mengwei666/microduck_scs225/readme.md

***20261104***
> 训练策略

***20261102***
>泰山派连接命令 ssh root@192.168.1.7 "uname -a"

***20261102***
> 整理文件

***20261101***
> 添加cda模型
> 添加腿部 SCS225 调试脚本与 RK3566 说明（docs/rk3566-legs-bringup.md）

***20261021***
> 添加cda模型
