mengwei666/microduck_scs225/microduck_cad/04、microduck_v2/microduck.SLDASM

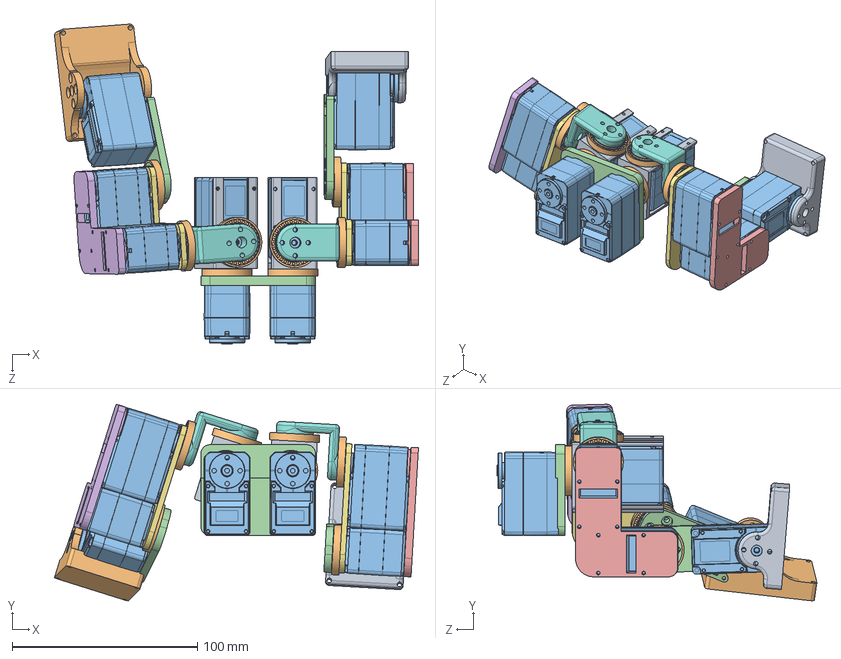
[picture p1: CAD file, 2026-11-01]
microduck_cad/04、microduck_v2/microduck.SLDASM
196.7 x 106.2 x 172.8 mm
01、主体结构
SCS225舵机 x 10
02、轴承_20_27_4X8 x 8
03、胯部X2 x 2
04、胯筋X2 x 2
05、大腿上盖X2 x 2
06、右大腿下盖
07、左大腿下盖
08、小腿X2 x 2
09、轴承_4_6_10X2 x 2
10、右脚踝
11、左脚踝
