mengwei666/microduck_scs225/microduck_cad/04、microduck_v2/SCS225舵机.SLDPRT

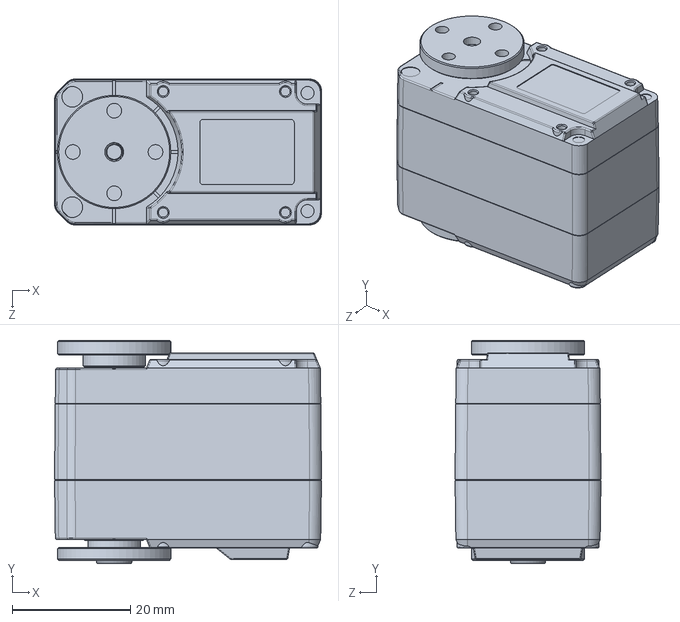
[picture p2: CAD file, 2026-11-01]
microduck_cad/04、microduck_v2/SCS225舵机.SLDPRT
45.2 x 37.8 x 24.7 mm
