mengwei666/microduck_scs225/microduck_cad/05、microduck_v3/08、小腿X2.SLDPRT

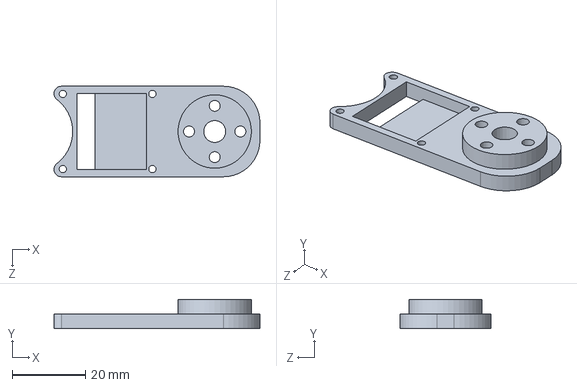
[picture p3: CAD file, 2026-11-01]
microduck_cad/05、microduck_v3/08、小腿X2.SLDPRT
56.2 x 8.00 x 24.7 mm
