mengwei666/microduck_scs225/microduck_cad/05、microduck_v3/stl/05、大腿上盖X2.STL

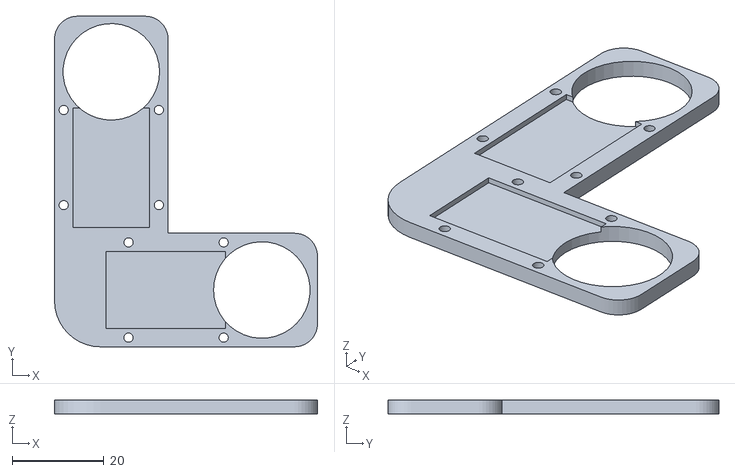
[picture p4: CAD file, 2026-11-01]
microduck_cad/05、microduck_v3/stl/05、大腿上盖X2.STL
57.2 x 71.9 x 3.00
