mengwei666/microduck_scs225/microduck_rl/src/mjlab_microduck/robot/microduck/assets/soft_mouth_top.stl

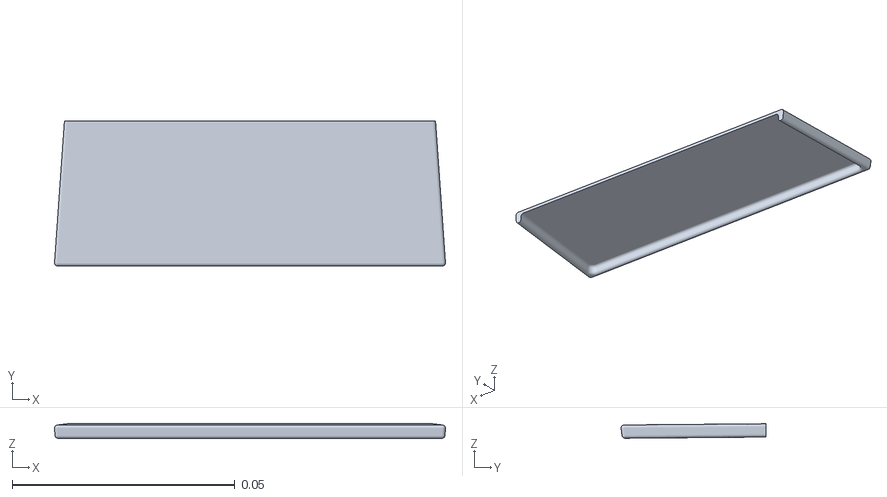
[picture p5: CAD file, 2026-11-01]
microduck_rl/src/mjlab_microduck/robot/microduck/assets/soft_mouth_top.stl
0.0878 x 0.0326 x 0.00328
