mengwei666/microduck_scs225/microduck_rl/src/mjlab_microduck/robot/xl330_test_bench/assets/part_4.stl

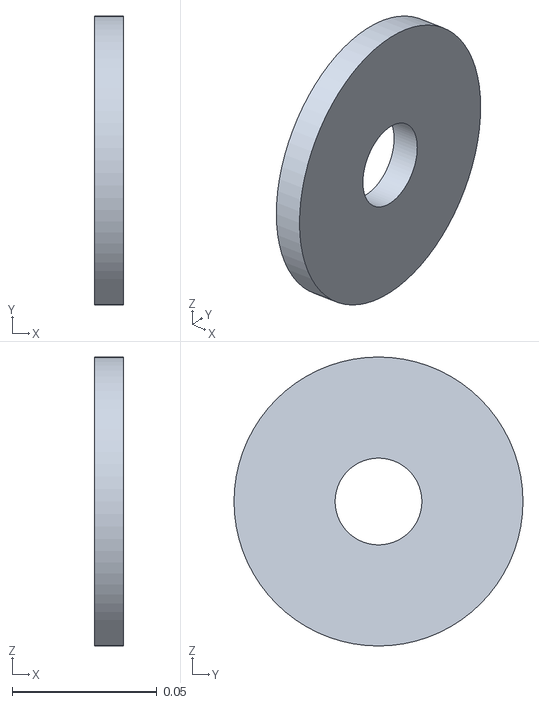
[picture p6: CAD file, 2026-11-01]
microduck_rl/src/mjlab_microduck/robot/xl330_test_bench/assets/part_4.stl
0.01 x 0.1 x 0.1
