mengwei666/microduck_scs225/microduck_cad/04、microduck_v2/09、轴承_4_6_10X2.SLDPRT

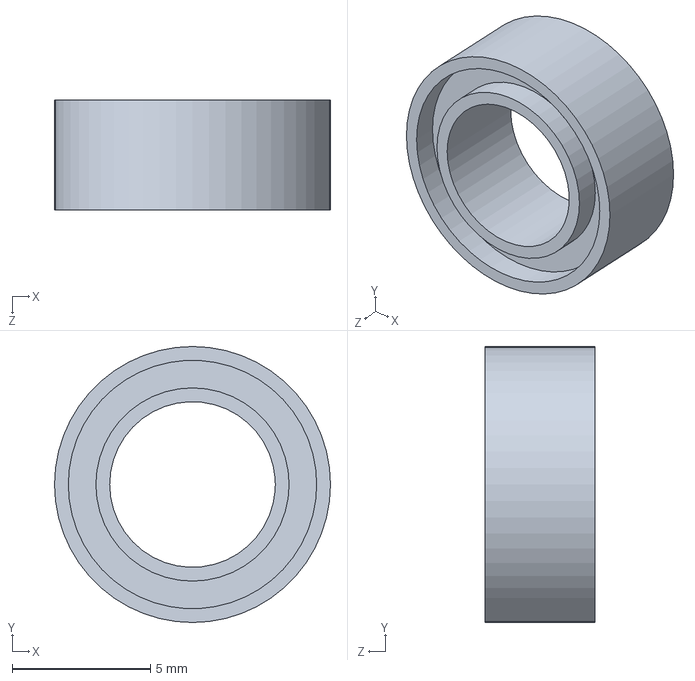
[picture p7: CAD file, 2026-11-01]
microduck_cad/04、microduck_v2/09、轴承_4_6_10X2.SLDPRT
10.0 x 10.0 x 4.00 mm
