mengwei666/microduck_scs225/microduck_cad/05、microduck_v3/10、右脚踝.SLDPRT

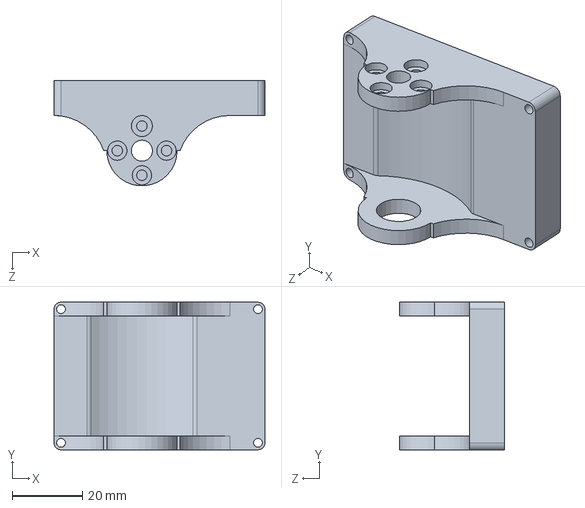
[picture p8: CAD file, 2026-11-01]
microduck_cad/05、microduck_v3/10、右脚踝.SLDPRT
60.0 x 42.0 x 30.0 mm
