mengwei666/microduck_scs225/microduck_rl/src/mjlab_microduck/robot/microduck/assets/motor_support.stl

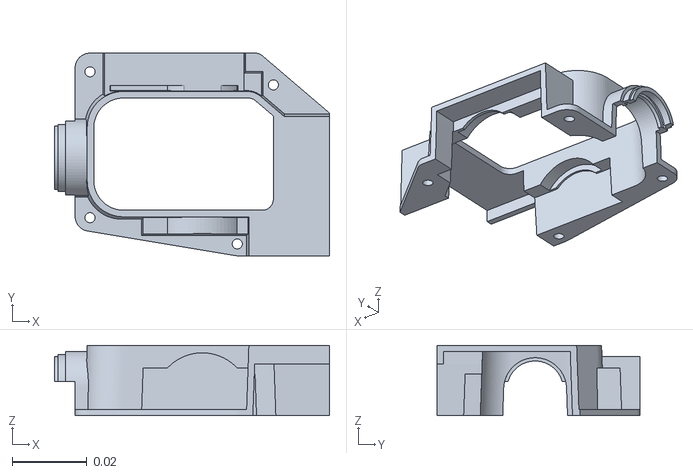
[picture p9: CAD file, 2026-11-01]
microduck_rl/src/mjlab_microduck/robot/microduck/assets/motor_support.stl
0.0735 x 0.0542 x 0.0188
