mengwei666/microduck_scs225/microduck_rl/src/mjlab_microduck/robot/xl330_test_bench/assets/part_5.stl

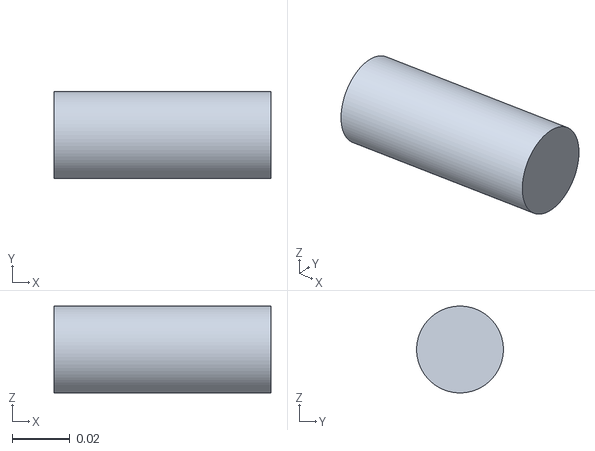
[picture p10: CAD file, 2026-11-01]
microduck_rl/src/mjlab_microduck/robot/xl330_test_bench/assets/part_5.stl
0.075 x 0.03 x 0.03
