mengwei666/microduck_scs225/microduck_cad/04、microduck_v2/10、右脚踝.SLDPRT

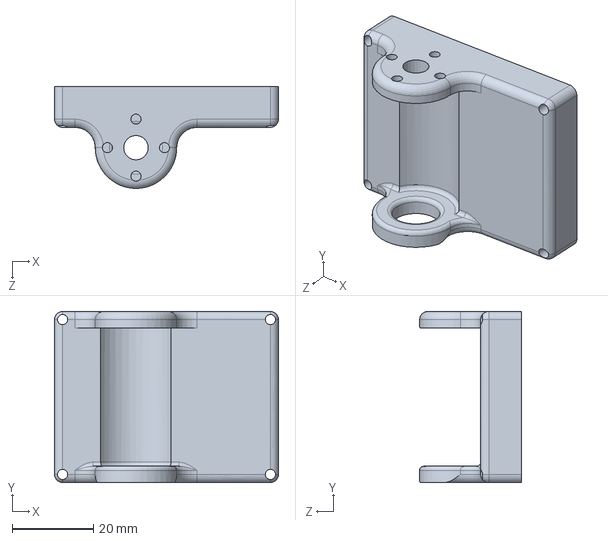
[picture p11: CAD file, 2026-11-01]
microduck_cad/04、microduck_v2/10、右脚踝.SLDPRT
55.0 x 42.0 x 25.0 mm
