mengwei666/microduck_scs225/microduck_cad/05、microduck_v3/02、轴承_20_27_4X8.SLDPRT

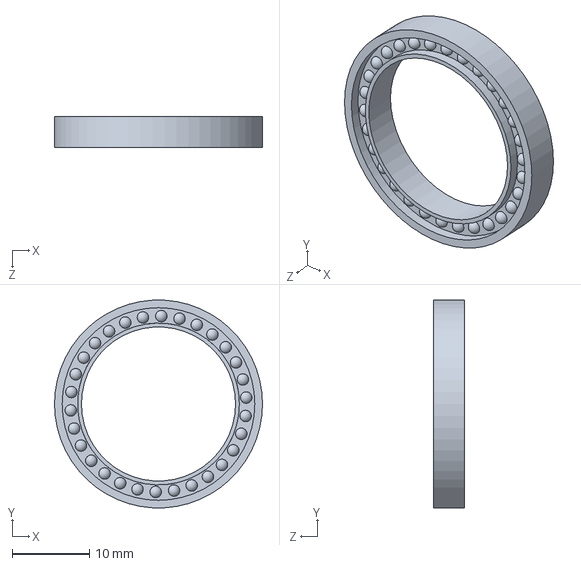
[picture p12: CAD file, 2026-11-01]
microduck_cad/05、microduck_v3/02、轴承_20_27_4X8.SLDPRT
27.0 x 27.0 x 4.00 mm
