mengwei666/microduck_scs225/microduck_rl/src/mjlab_microduck/robot/microduck/assets/tire.stl

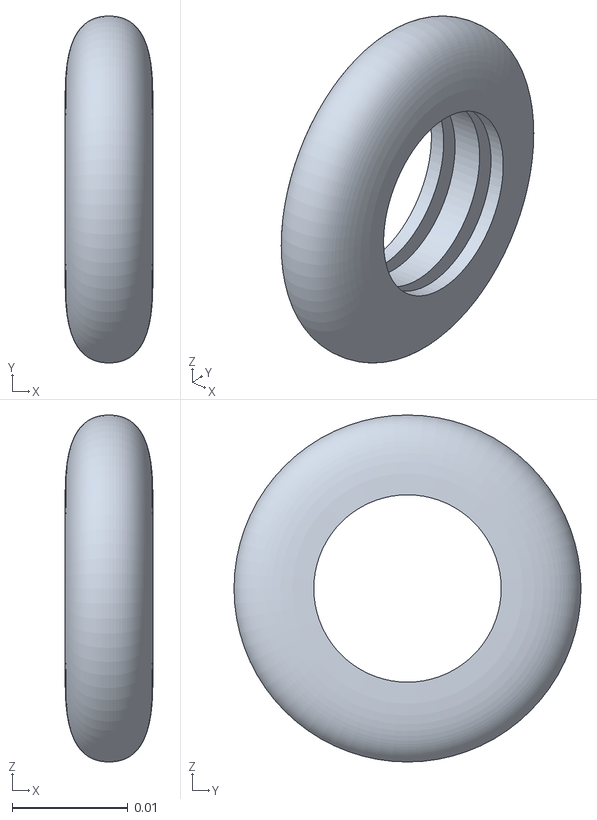
[picture p13: CAD file, 2026-11-01]
microduck_rl/src/mjlab_microduck/robot/microduck/assets/tire.stl
0.0076 x 0.03 x 0.03
