mengwei666/microduck_scs225/microduck_rl/src/mjlab_microduck/robot/xl330_test_bench/assets/part_1.stl

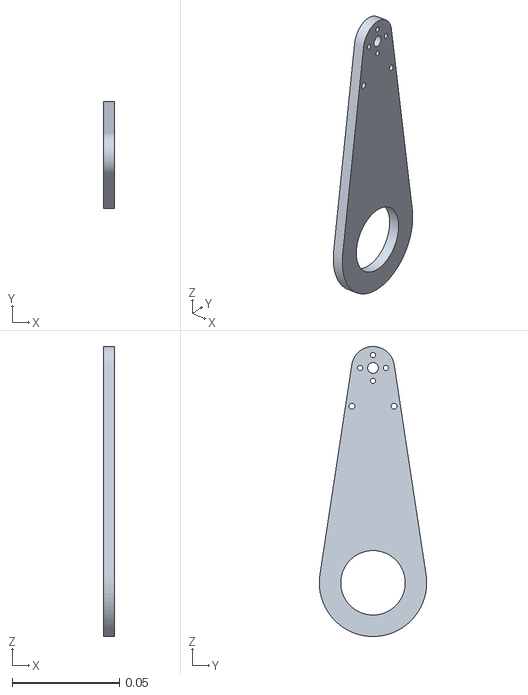
[picture p14: CAD file, 2026-11-01]
microduck_rl/src/mjlab_microduck/robot/xl330_test_bench/assets/part_1.stl
0.005 x 0.05 x 0.135
