mengwei666/microduck_scs225/microduck_cad/04、microduck_v2/04、胯筋X2.SLDPRT

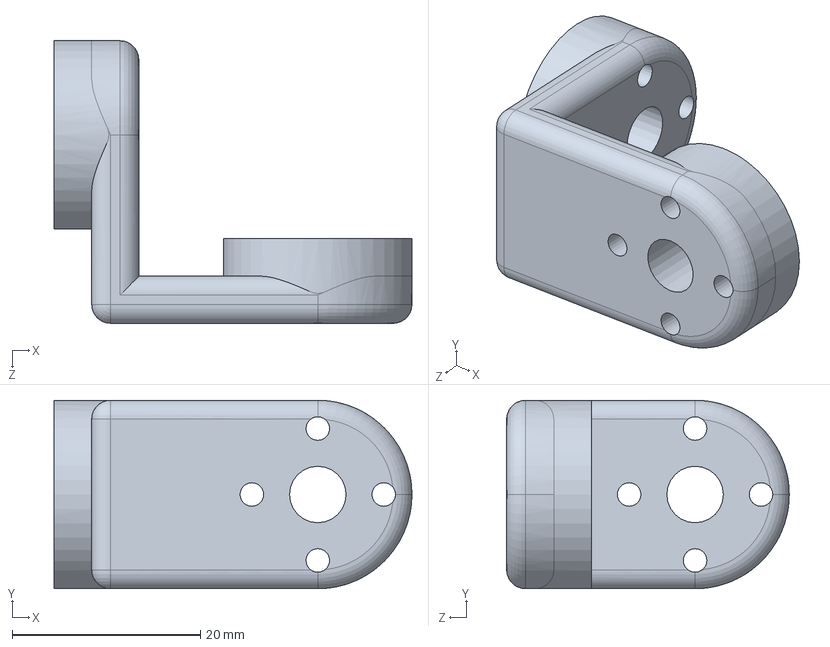
[picture p15: CAD file, 2026-11-01]
microduck_cad/04、microduck_v2/04、胯筋X2.SLDPRT
38.0 x 20.0 x 30.0 mm
