mengwei666/microduck_scs225/microduck_cad/05、microduck_v3/01、主体结构.SLDPRT

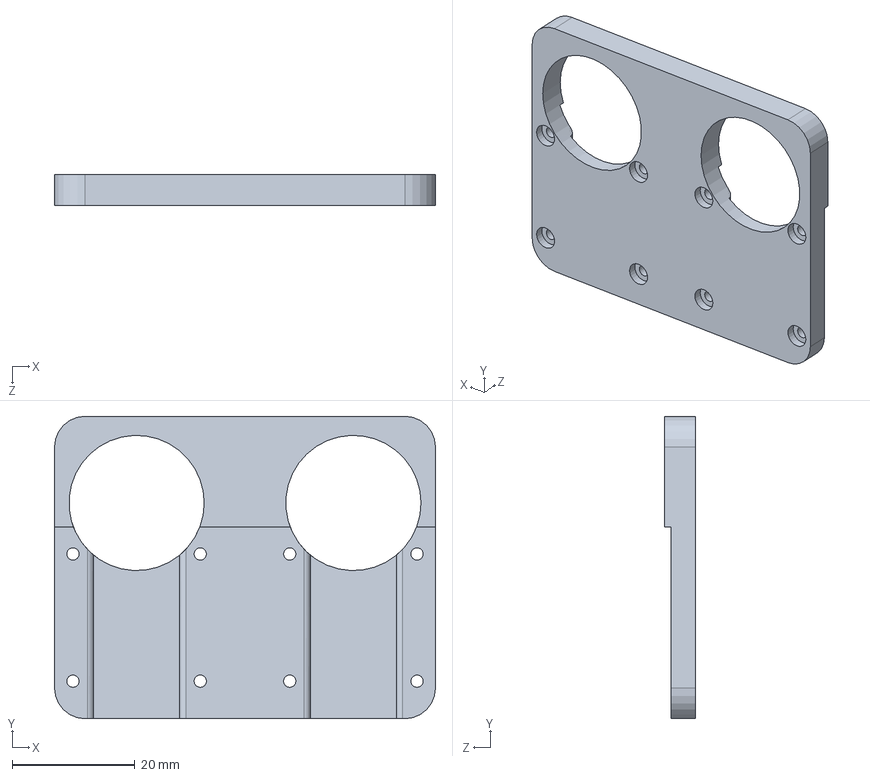
[picture p16: CAD file, 2026-11-01]
microduck_cad/05、microduck_v3/01、主体结构.SLDPRT
62.0 x 49.2 x 5.00 mm
