mengwei666/microduck_scs225/microduck_rl/src/mjlab_microduck/robot/microduck/assets/bottom_head_shell.stl

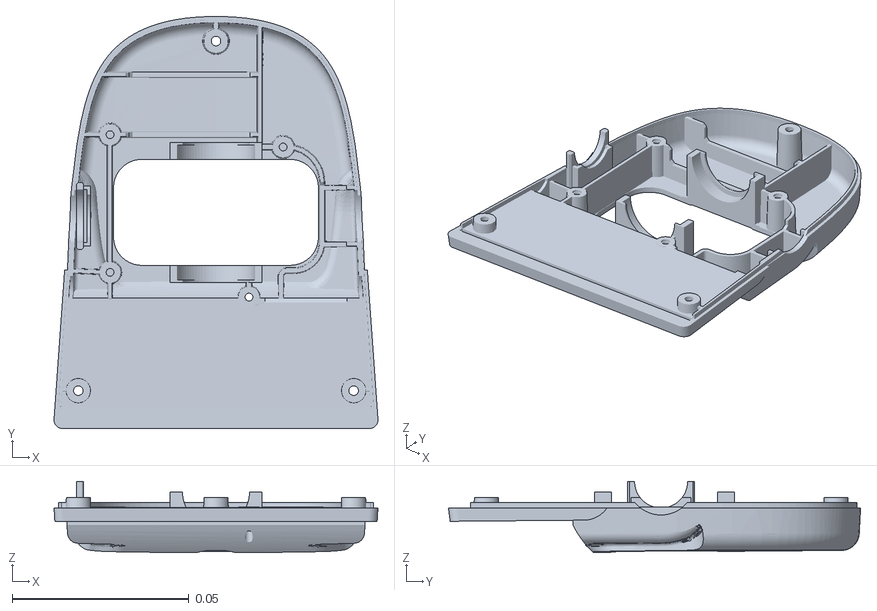
[picture p17: CAD file, 2026-11-01]
microduck_rl/src/mjlab_microduck/robot/microduck/assets/bottom_head_shell.stl
0.0918 x 0.117 x 0.0201
