mengwei666/microduck_scs225/microduck_cad/04、microduck_v2/06、右大腿下盖.SLDPRT

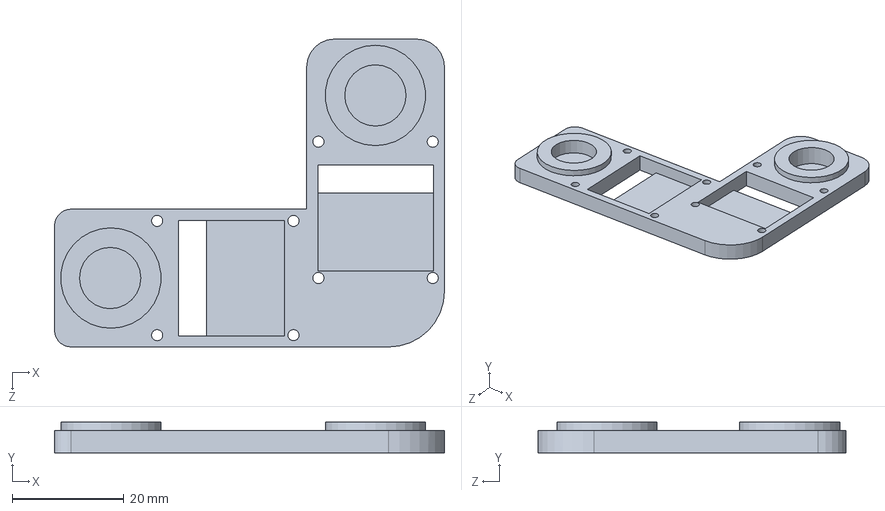
[picture p18: CAD file, 2026-11-01]
microduck_cad/04、microduck_v2/06、右大腿下盖.SLDPRT
69.9 x 5.50 x 55.2 mm
