mengwei666/microduck_scs225/microduck_cad/05、microduck_v3/03、胯部X2.SLDPRT

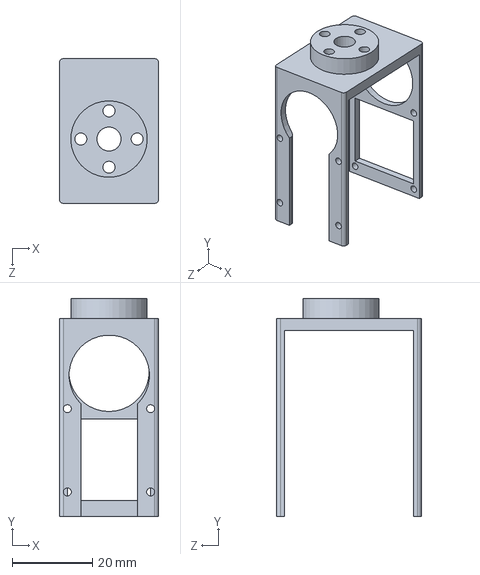
[picture p19: CAD file, 2026-11-01]
microduck_cad/05、microduck_v3/03、胯部X2.SLDPRT
24.7 x 54.2 x 36.0 mm
