mengwei666/microduck_scs225/microduck_rl/src/mjlab_microduck/robot/microduck/assets/ankle_l_v1.stl

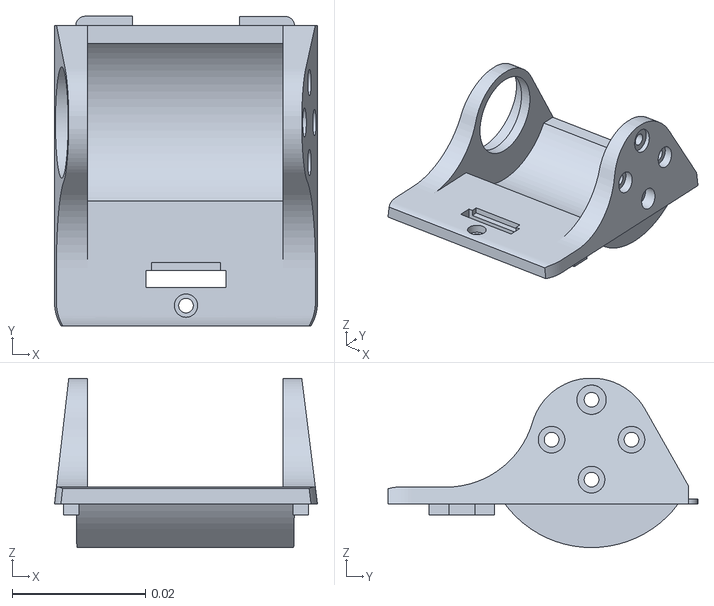
[picture p20: CAD file, 2026-11-01]
microduck_rl/src/mjlab_microduck/robot/microduck/assets/ankle_l_v1.stl
0.0395 x 0.0465 x 0.0254
