mengwei666/microduck_scs225/microduck_rl/src/mjlab_microduck/robot/xl330_test_bench/assets/spacer.stl

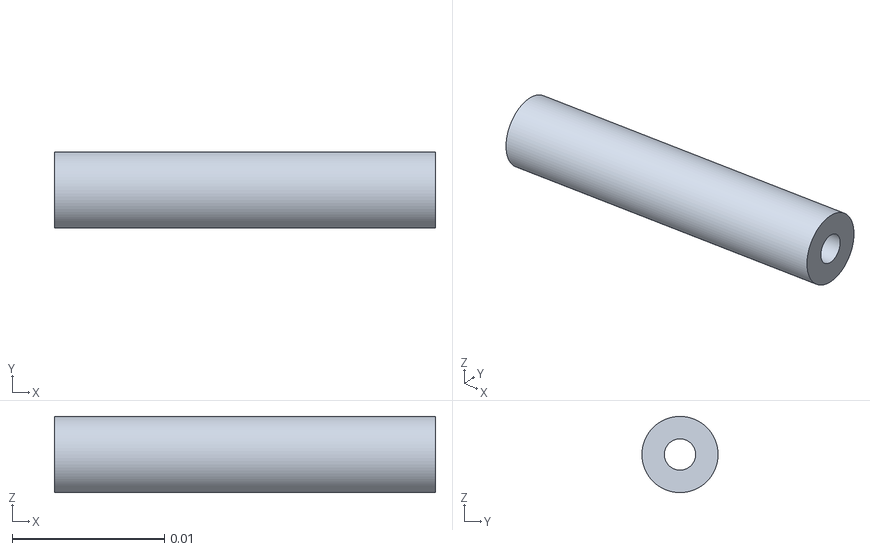
[picture p21: CAD file, 2026-11-01]
microduck_rl/src/mjlab_microduck/robot/xl330_test_bench/assets/spacer.stl
0.025 x 0.005 x 0.005
