mengwei666/microduck_scs225/microduck_cad/04、microduck_v2/03、胯部X2.SLDPRT

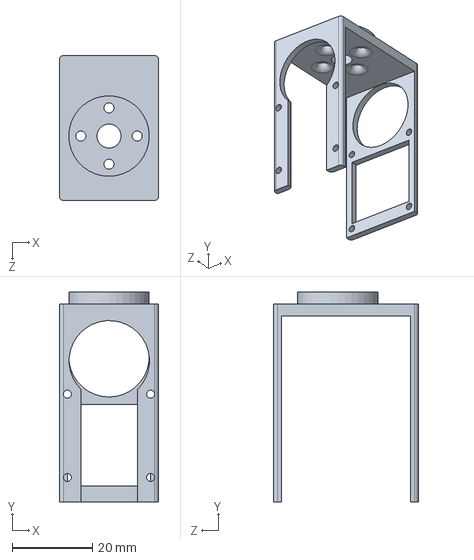
[picture p22: CAD file, 2026-11-01]
microduck_cad/04、microduck_v2/03、胯部X2.SLDPRT
24.7 x 52.2 x 36.0 mm
