mengwei666/microduck_scs225/microduck_cad/05、microduck_v3/04、胯筋X2.SLDPRT

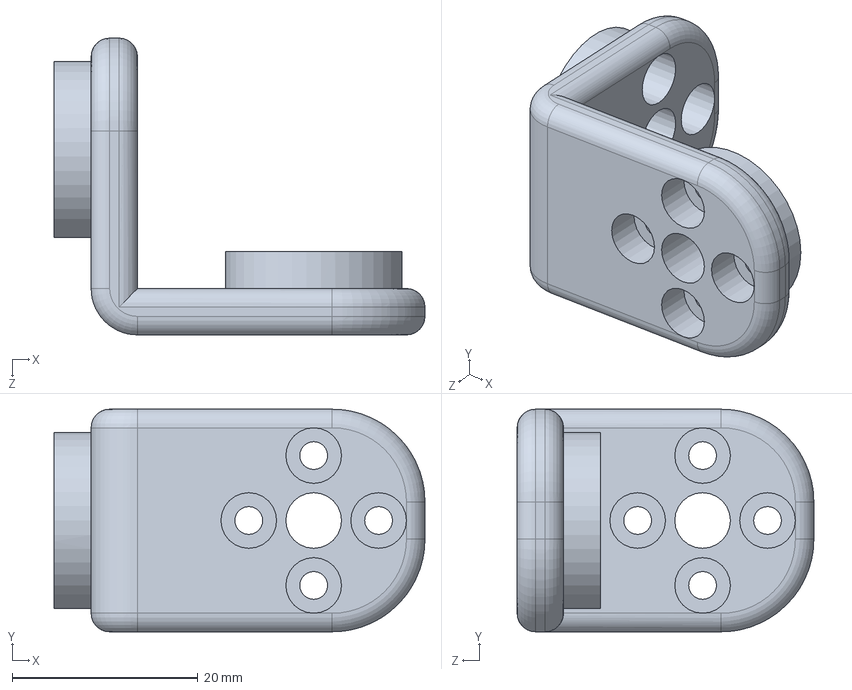
[picture p23: CAD file, 2026-11-01]
microduck_cad/05、microduck_v3/04、胯筋X2.SLDPRT
40.0 x 24.0 x 32.0 mm
