mengwei666/microduck_scs225/microduck_rl/src/mjlab_microduck/robot/microduck/assets/ankle_right.stl

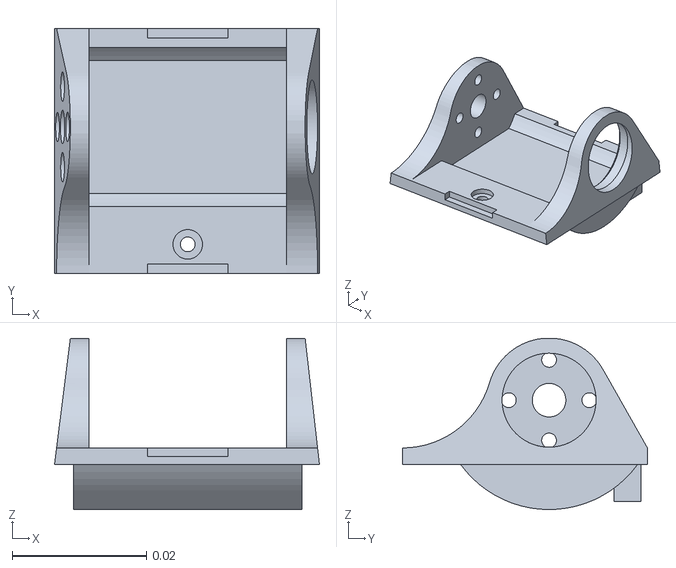
[picture p24: CAD file, 2026-11-01]
microduck_rl/src/mjlab_microduck/robot/microduck/assets/ankle_right.stl
0.0395 x 0.0365 x 0.0255
