mengwei666/microduck_scs225/microduck_cad/04、microduck_v2/08、小腿X2.SLDPRT

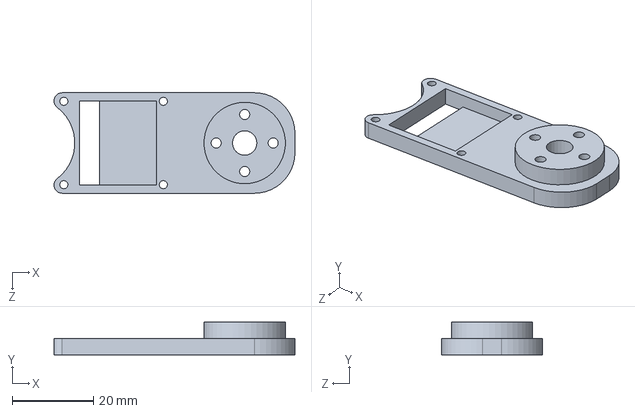
[picture p25: CAD file, 2026-11-01]
microduck_cad/04、microduck_v2/08、小腿X2.SLDPRT
59.2 x 8.00 x 24.7 mm
