mengwei666/microduck_scs225/microduck_rl/src/mjlab_microduck/robot/microduck/assets/roller_blade.stl

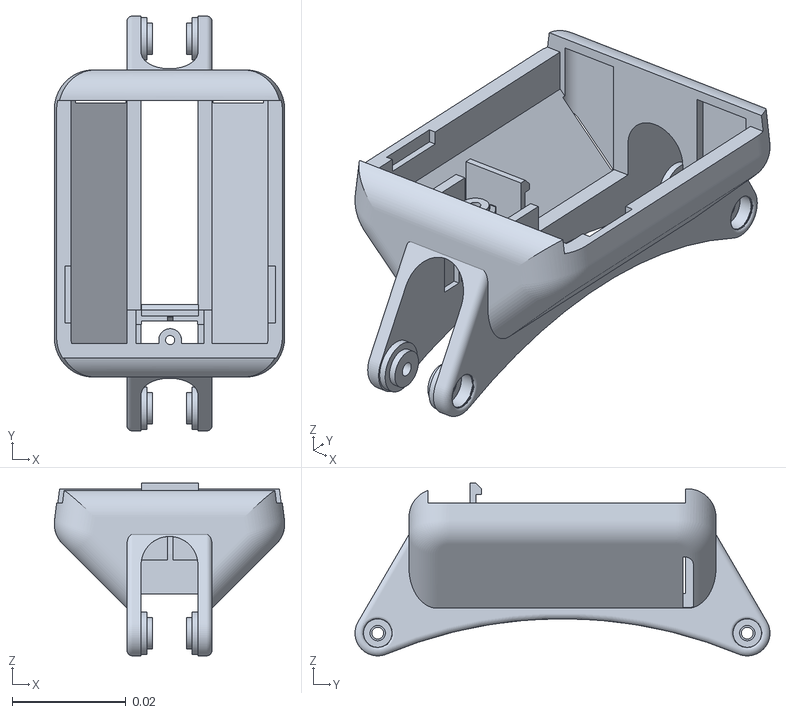
[picture p27: CAD file, 2026-11-01]
microduck_rl/src/mjlab_microduck/robot/microduck/assets/roller_blade.stl
0.0405 x 0.073 x 0.0304
