mengwei666/microduck_scs225/microduck_rl/src/mjlab_microduck/robot/microduck/assets/lens.stl

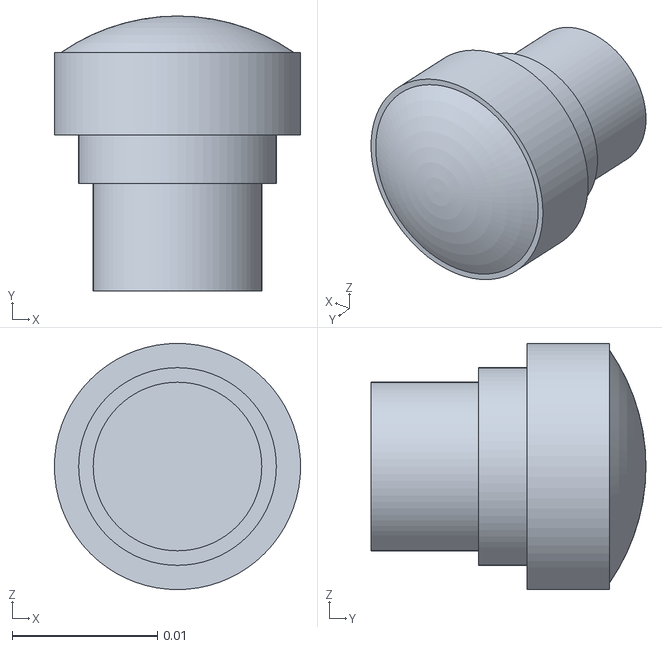
[picture p29: CAD file, 2026-11-01]
microduck_rl/src/mjlab_microduck/robot/microduck/assets/lens.stl
0.0169 x 0.0189 x 0.0169
