mengwei666/microduck_scs225/microduck_cad/04、microduck_v2/05、大腿上盖X2.SLDPRT

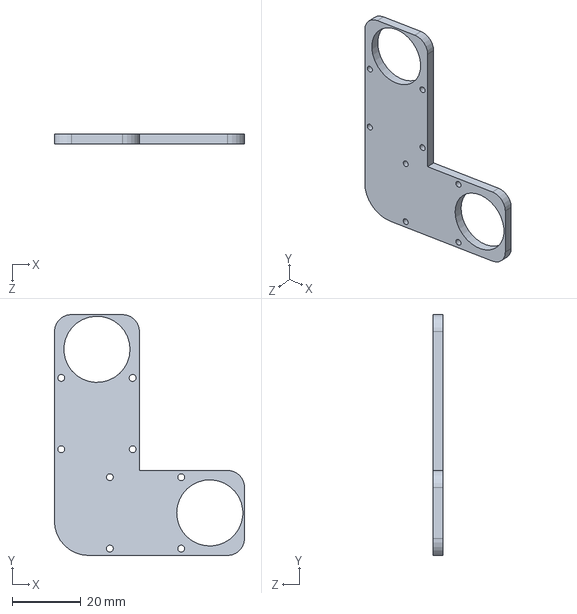
[picture p30: CAD file, 2026-11-01]
microduck_cad/04、microduck_v2/05、大腿上盖X2.SLDPRT
55.2 x 69.9 x 3.00 mm
