mengwei666/microduck_scs225/microduck_rl/src/mjlab_microduck/robot/microduck/assets/jaw.stl

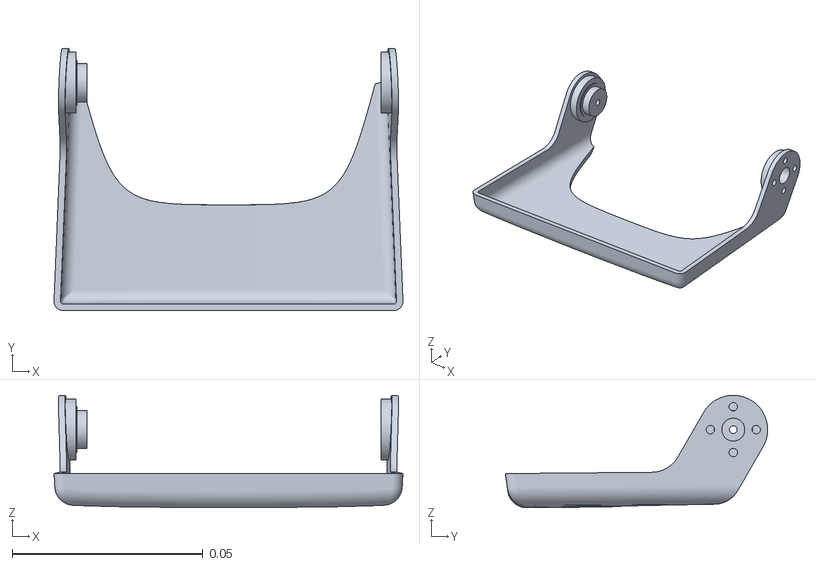
[picture p31: CAD file, 2026-11-01]
microduck_rl/src/mjlab_microduck/robot/microduck/assets/jaw.stl
0.0914 x 0.0687 x 0.0294
