mengwei666/microduck_scs225/microduck_cad/04、microduck_v2/01、主体结构.SLDPRT

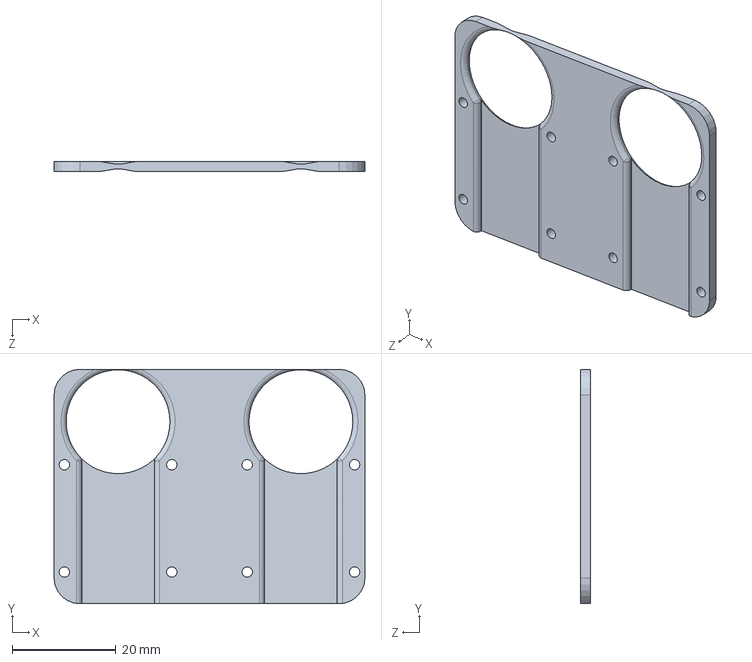
[picture p32: CAD file, 2026-11-01]
microduck_cad/04、microduck_v2/01、主体结构.SLDPRT
60.0 x 45.2 x 2.00 mm
