mengwei666/microduck_scs225/microduck_rl/src/mjlab_microduck/robot/microduck/assets/foot_left.stl

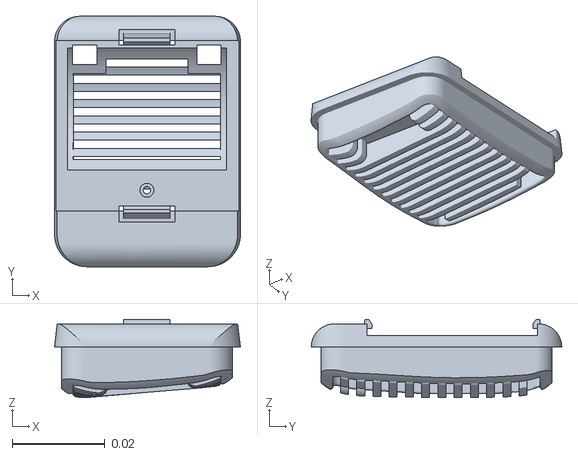
[picture p33: CAD file, 2026-11-01]
microduck_rl/src/mjlab_microduck/robot/microduck/assets/foot_left.stl
0.0401 x 0.054 x 0.0169
