mengwei666/microduck_scs225/microduck_rl/src/mjlab_microduck/robot/microduck/assets/sole_left.stl

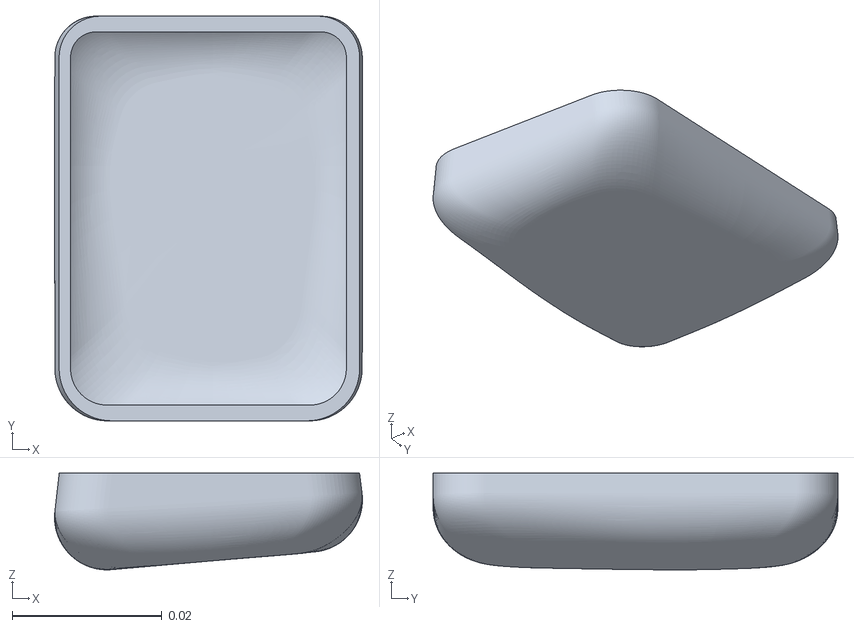
[picture p34: CAD file, 2026-11-01]
microduck_rl/src/mjlab_microduck/robot/microduck/assets/sole_left.stl
0.0411 x 0.054 x 0.0129
