mengwei666/microduck_scs225/microduck_rl/src/mjlab_microduck/robot/microduck/assets/upper_leg_rigidity_plate.stl

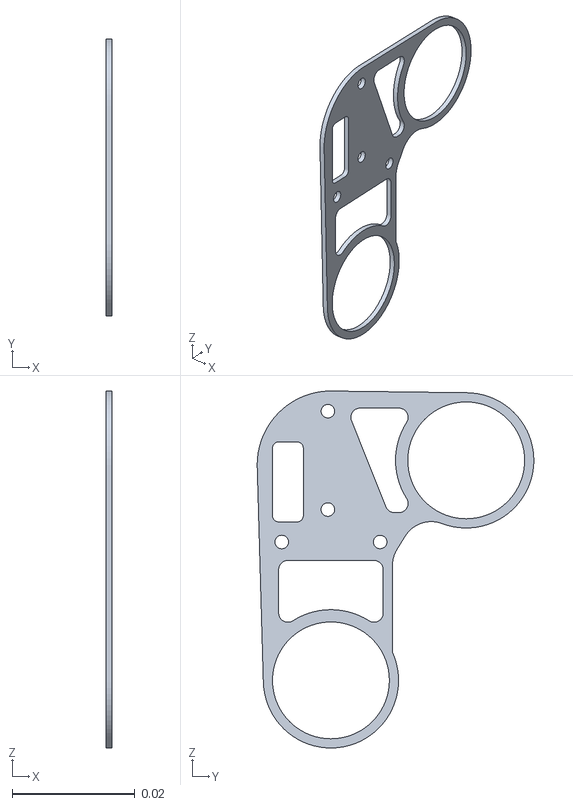
[picture p35: CAD file, 2026-11-01]
microduck_rl/src/mjlab_microduck/robot/microduck/assets/upper_leg_rigidity_plate.stl
0.001 x 0.045 x 0.0581
