mengwei666/microduck_scs225/microduck_rl/src/mjlab_microduck/robot/microduck/assets/seeed_bearing__configuration__22x16x4.stl

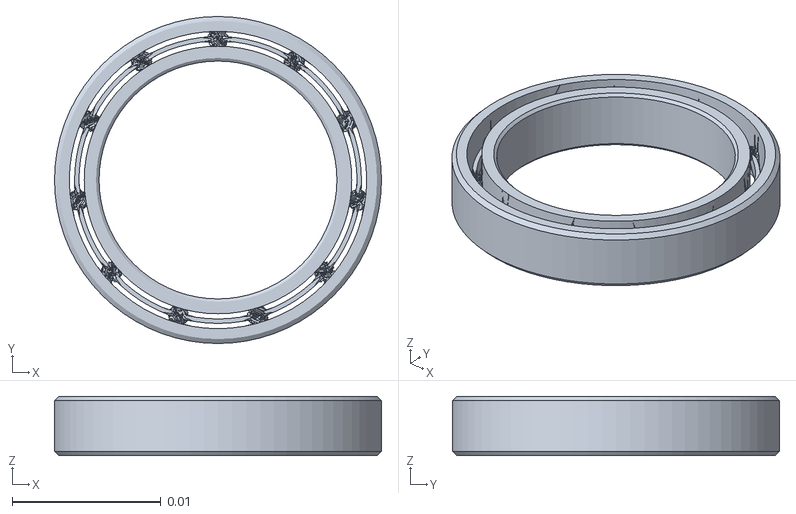
[picture p36: CAD file, 2026-11-01]
microduck_rl/src/mjlab_microduck/robot/microduck/assets/seeed_bearing__configuration__22x16x4.stl
0.022 x 0.022 x 0.004
