mengwei666/microduck_scs225/microduck_rl/src/mjlab_microduck/robot/microduck/assets/yaw2roll.stl

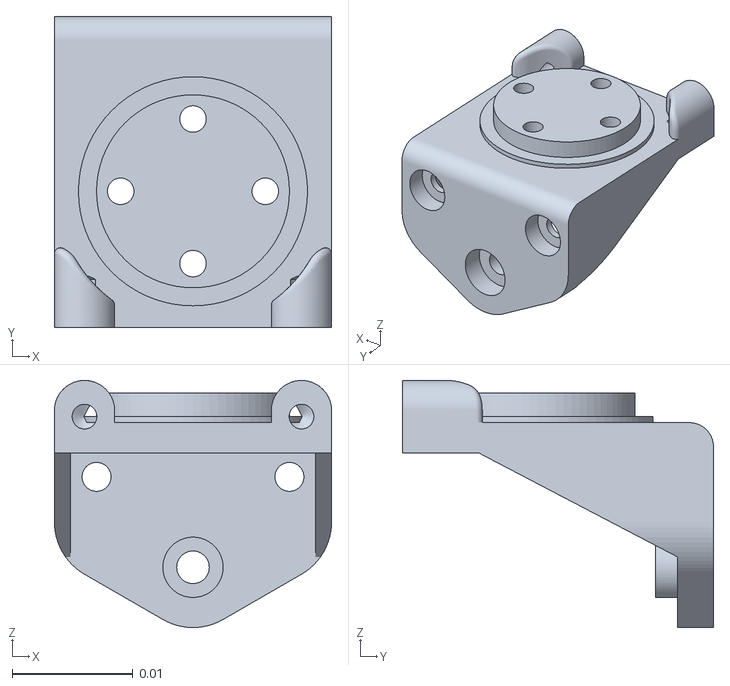
[picture p37: CAD file, 2026-11-01]
microduck_rl/src/mjlab_microduck/robot/microduck/assets/yaw2roll.stl
0.023 x 0.0258 x 0.0205
