mengwei666/microduck_scs225/microduck_rl/src/mjlab_microduck/robot/microduck/assets/leg.stl

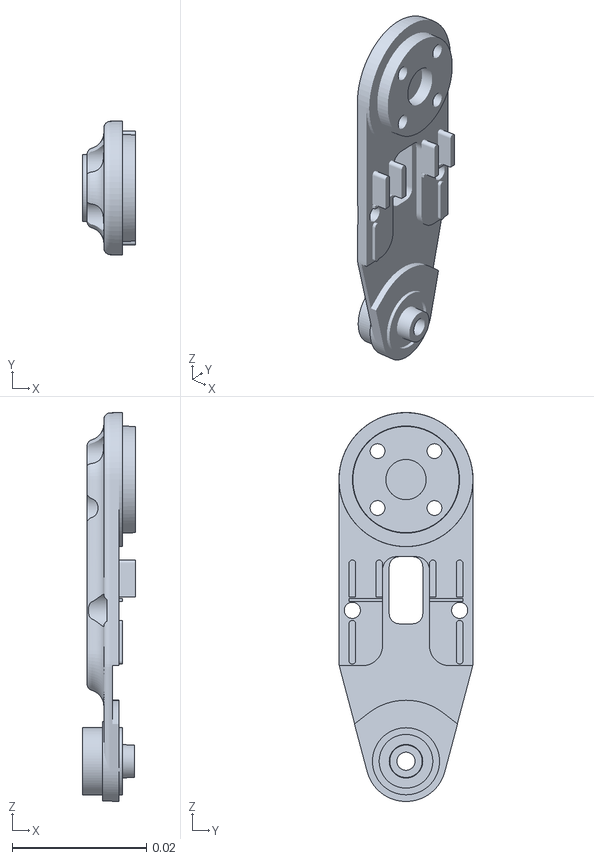
[picture p38: CAD file, 2026-11-01]
microduck_rl/src/mjlab_microduck/robot/microduck/assets/leg.stl
0.00795 x 0.02 x 0.058
