mengwei666/microduck_scs225/microduck_rl/src/mjlab_microduck/robot/microduck/assets/bearing_roll.stl

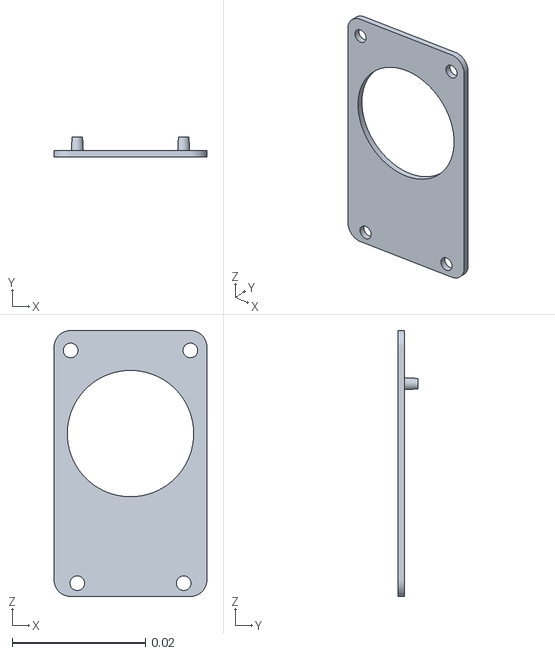
[picture p39: CAD file, 2026-11-01]
microduck_rl/src/mjlab_microduck/robot/microduck/assets/bearing_roll.stl
0.023 x 0.003 x 0.04
