mengwei666/microduck_scs225/microduck_rl/src/mjlab_microduck/robot/microduck/assets/banana_pcb_locker.stl

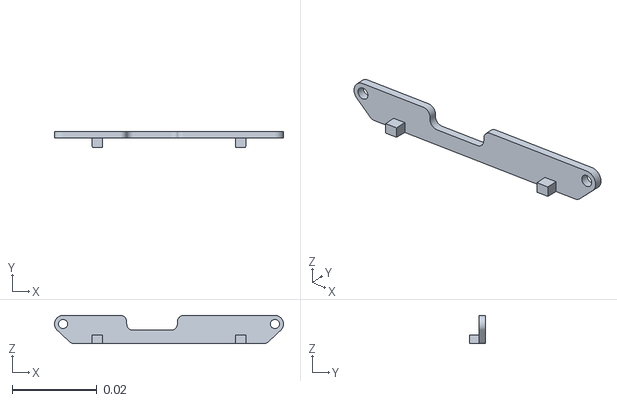
[picture p40: CAD file, 2026-11-01]
microduck_rl/src/mjlab_microduck/robot/microduck/assets/banana_pcb_locker.stl
0.0541 x 0.0038 x 0.00665
