mengwei666/microduck_scs225/microduck_rl/src/mjlab_microduck/robot/microduck/assets/top_head_shell.stl

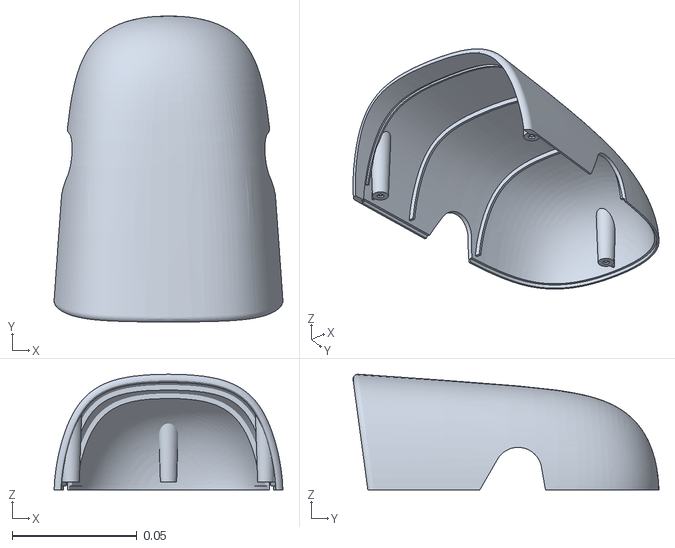
[picture p41: CAD file, 2026-11-01]
microduck_rl/src/mjlab_microduck/robot/microduck/assets/top_head_shell.stl
0.0918 x 0.123 x 0.0463
