mengwei666/microduck_scs225/microduck_rl/src/mjlab_microduck/robot/microduck/assets/upper_leg_right.stl

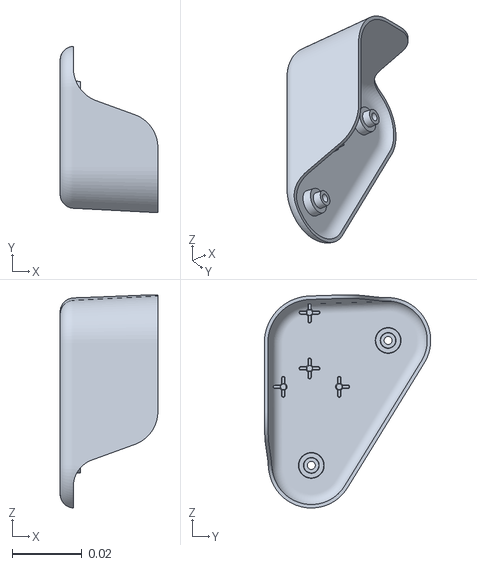
[picture p42: CAD file, 2026-11-01]
microduck_rl/src/mjlab_microduck/robot/microduck/assets/upper_leg_right.stl
0.028 x 0.0477 x 0.061
