mengwei666/microduck_scs225/microduck_rl/src/mjlab_microduck/robot/microduck/assets/power_support.stl

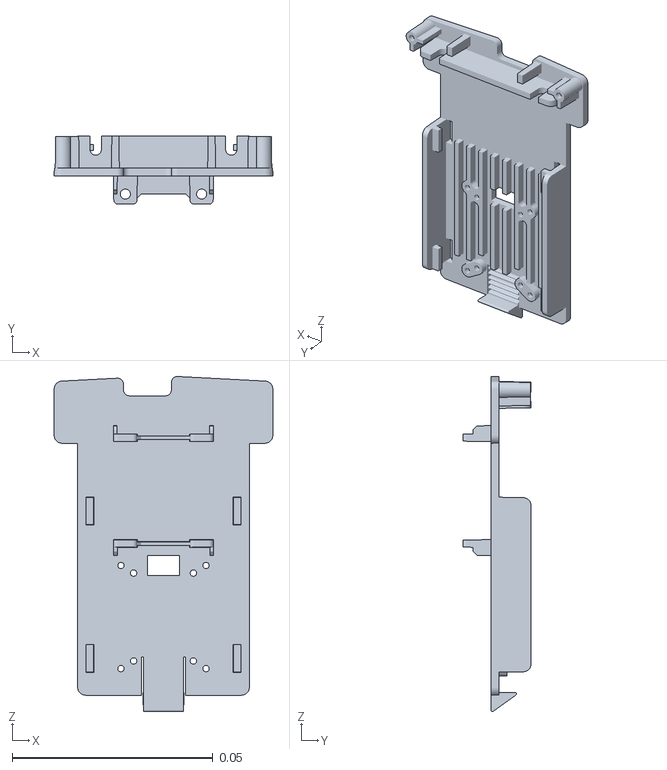
[picture p43: CAD file, 2026-11-01]
microduck_rl/src/mjlab_microduck/robot/microduck/assets/power_support.stl
0.0545 x 0.017 x 0.0835
