mengwei666/microduck_scs225/microduck_rl/src/mjlab_microduck/robot/microduck/assets/rim.stl

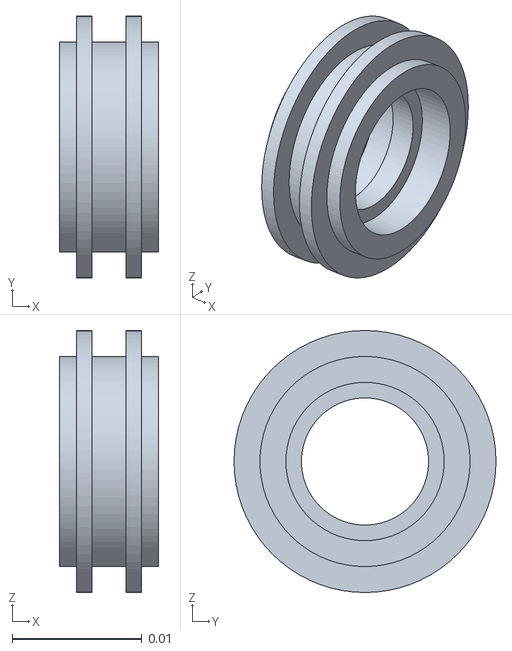
[picture p44: CAD file, 2026-11-01]
microduck_rl/src/mjlab_microduck/robot/microduck/assets/rim.stl
0.0076 x 0.0202 x 0.0202
