mengwei666/microduck_scs225/microduck_rl/src/mjlab_microduck/robot/microduck/assets/seeed_bearing__configuration_default.stl

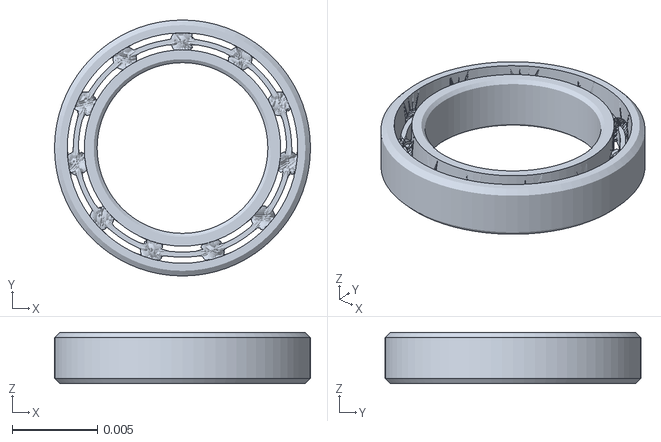
[picture p45: CAD file, 2026-11-01]
microduck_rl/src/mjlab_microduck/robot/microduck/assets/seeed_bearing__configuration_default.stl
0.015 x 0.015 x 0.003
