mengwei666/microduck_scs225/microduck_rl/src/mjlab_microduck/robot/microduck/assets/trunk_base.stl

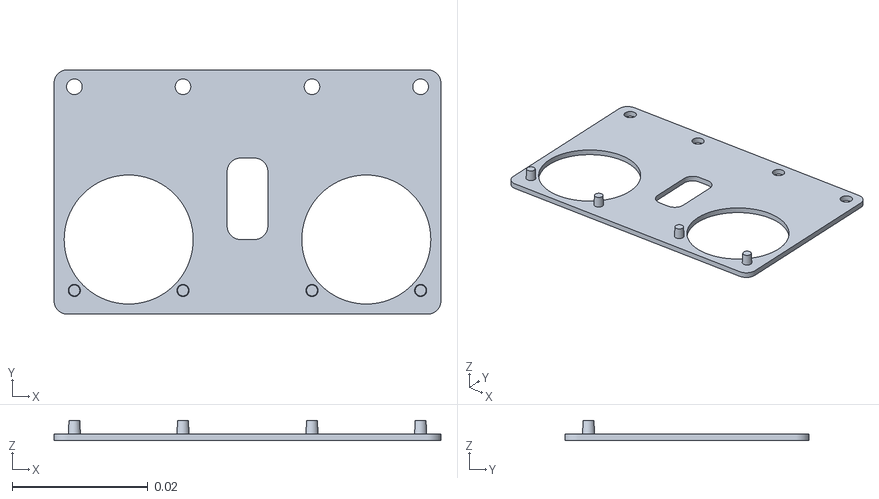
[picture p46: CAD file, 2026-11-01]
microduck_rl/src/mjlab_microduck/robot/microduck/assets/trunk_base.stl
0.057 x 0.036 x 0.003
