mengwei666/microduck_scs225/microduck_rl/src/mjlab_microduck/robot/microduck/assets/yaw_roll_motion.stl

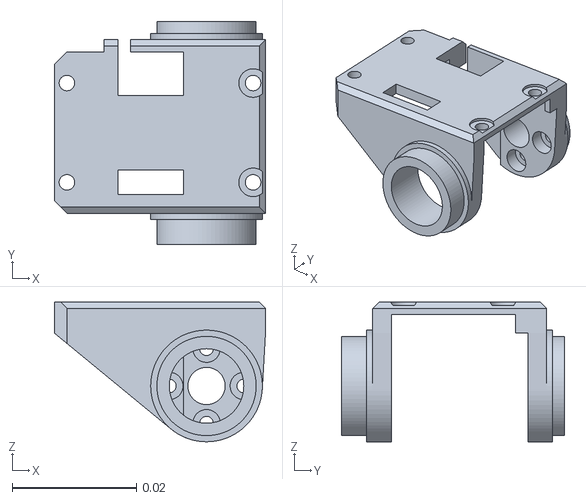
[picture p47: CAD file, 2026-11-01]
microduck_rl/src/mjlab_microduck/robot/microduck/assets/yaw_roll_motion.stl
0.034 x 0.0359 x 0.0225
