mengwei666/microduck_scs225/microduck_rl/src/mjlab_microduck/robot/microduck/assets/np_f970.stl

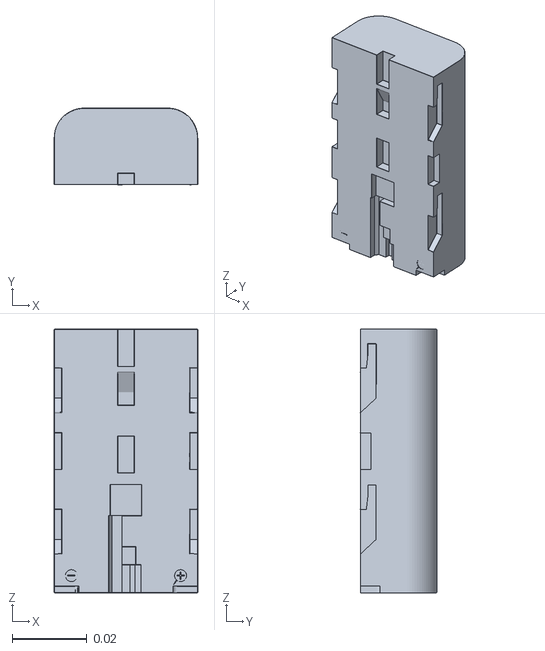
[picture p48: CAD file, 2026-11-01]
microduck_rl/src/mjlab_microduck/robot/microduck/assets/np_f970.stl
0.0386 x 0.0206 x 0.0708
