mengwei666/microduck_scs225/microduck_rl/src/mjlab_microduck/robot/microduck/assets/right_shell.stl

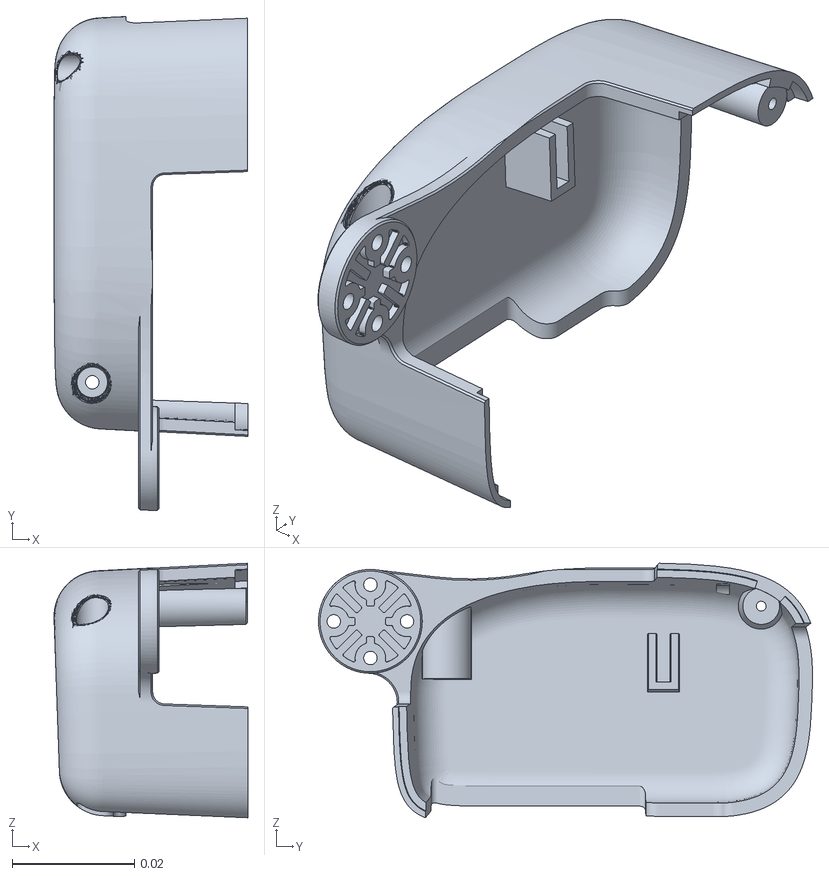
[picture p49: CAD file, 2026-11-01]
microduck_rl/src/mjlab_microduck/robot/microduck/assets/right_shell.stl
0.0318 x 0.0809 x 0.0417
