mengwei666/microduck_scs225/microduck_rl/src/mjlab_microduck/robot/microduck/assets/pcb__raspberry_pi_zero_2_w.stl

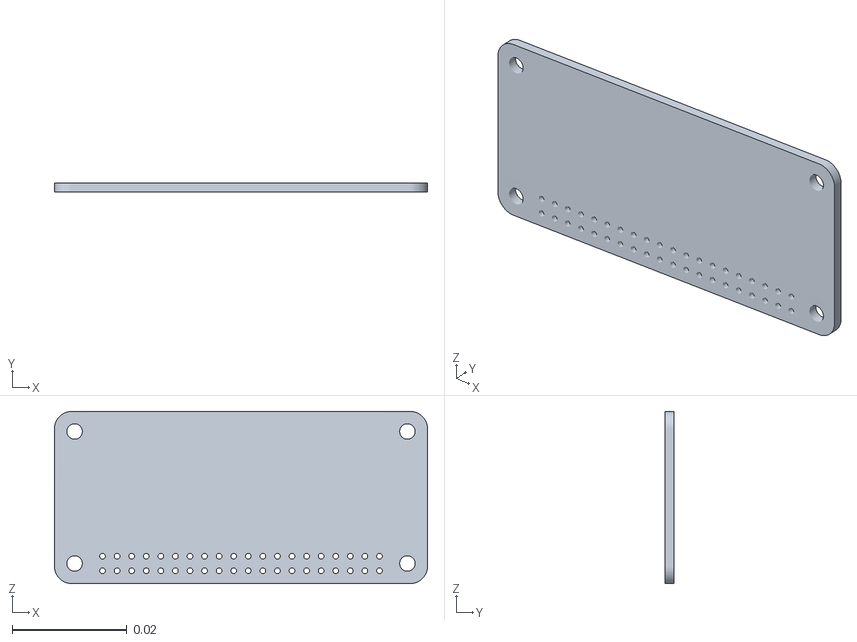
[picture p50: CAD file, 2026-11-01]
microduck_rl/src/mjlab_microduck/robot/microduck/assets/pcb__raspberry_pi_zero_2_w.stl
0.065 x 0.0016 x 0.03
