mengwei666/microduck_scs225/microduck_rl/src/mjlab_microduck/robot/microduck/assets/m12_lens_holder.stl

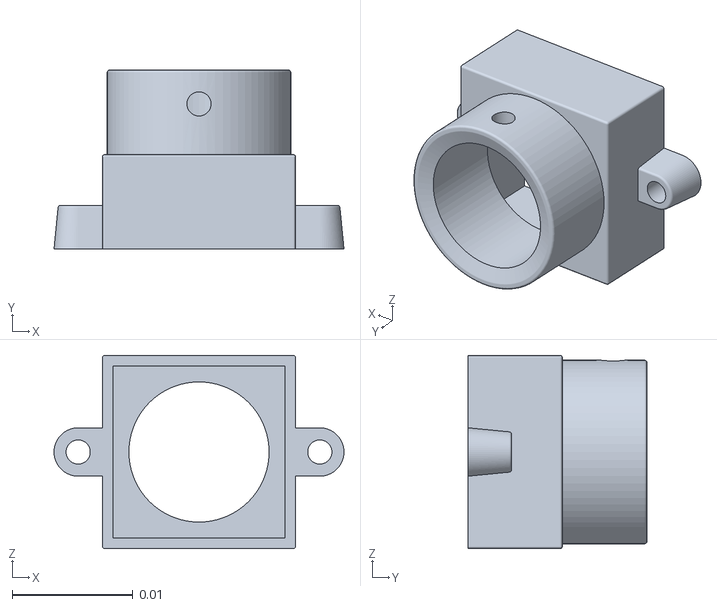
[picture p51: CAD file, 2026-11-01]
microduck_rl/src/mjlab_microduck/robot/microduck/assets/m12_lens_holder.stl
0.024 x 0.0148 x 0.016
