mengwei666/microduck_scs225/microduck_rl/src/mjlab_microduck/robot/microduck/assets/jaw_soft.stl

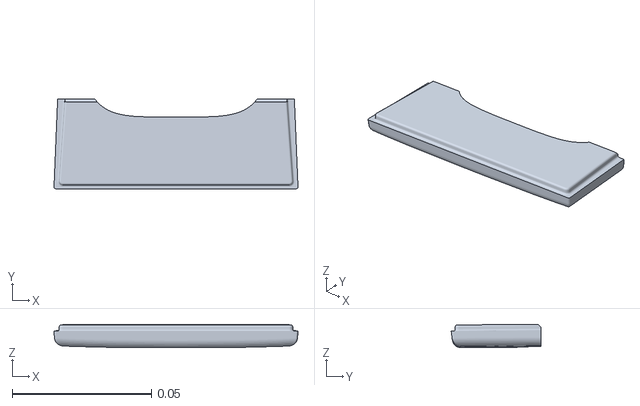
[picture p52: CAD file, 2026-11-01]
microduck_rl/src/mjlab_microduck/robot/microduck/assets/jaw_soft.stl
0.0877 x 0.0322 x 0.00844
