mengwei666/microduck_scs225/microduck_rl/src/mjlab_microduck/robot/microduck/assets/face_part.stl

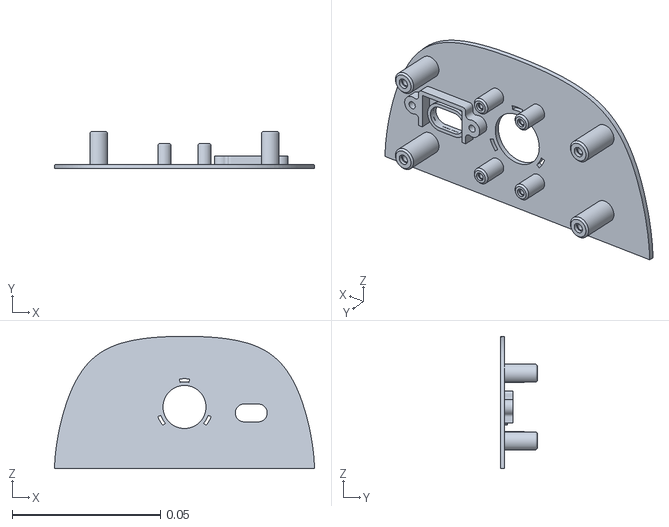
[picture p53: CAD file, 2026-11-01]
microduck_rl/src/mjlab_microduck/robot/microduck/assets/face_part.stl
0.0877 x 0.0125 x 0.0446
