mengwei666/microduck_scs225/microduck_rl/src/mjlab_microduck/robot/microduck/assets/neck_pitch.stl

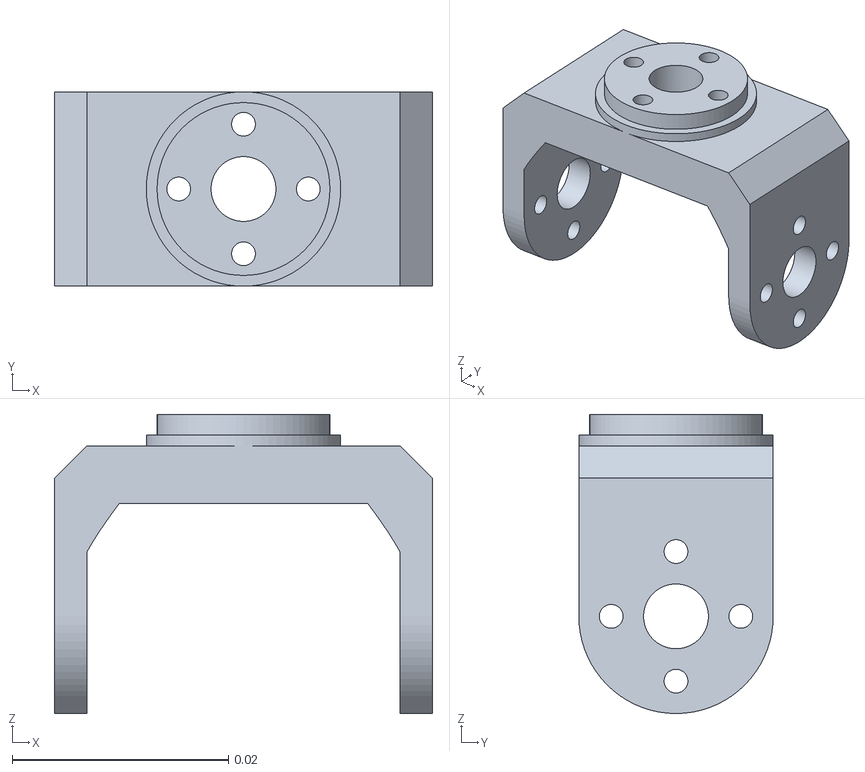
[picture p54: CAD file, 2026-11-01]
microduck_rl/src/mjlab_microduck/robot/microduck/assets/neck_pitch.stl
0.035 x 0.018 x 0.0277
