mengwei666/microduck_scs225/microduck_rl/src/mjlab_microduck/robot/microduck/assets/noenoeil.stl

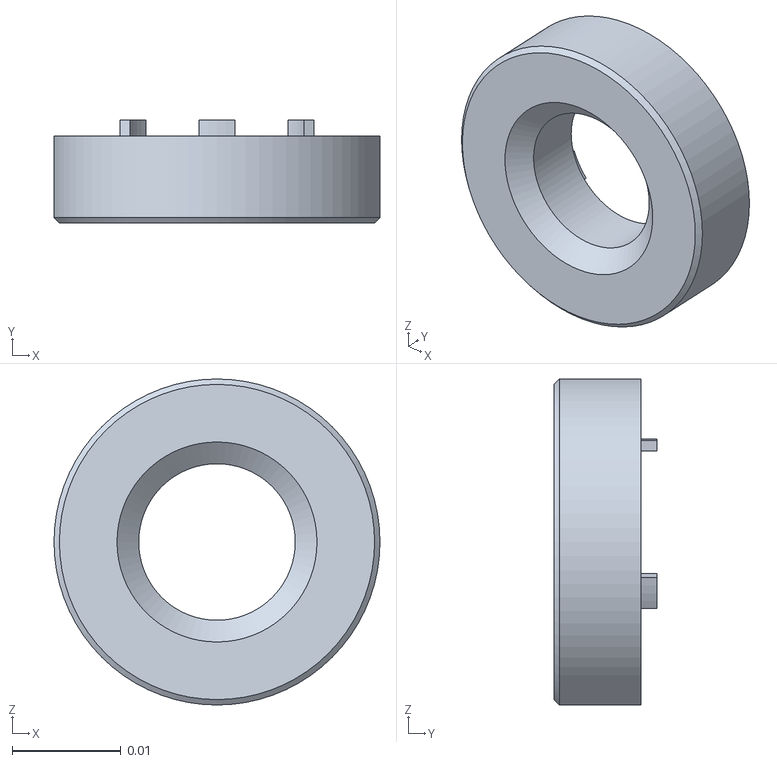
[picture p56: CAD file, 2026-11-01]
microduck_rl/src/mjlab_microduck/robot/microduck/assets/noenoeil.stl
0.03 x 0.0095 x 0.03
