mengwei666/microduck_scs225/microduck_rl/src/mjlab_microduck/robot/microduck/assets/hip_l.stl

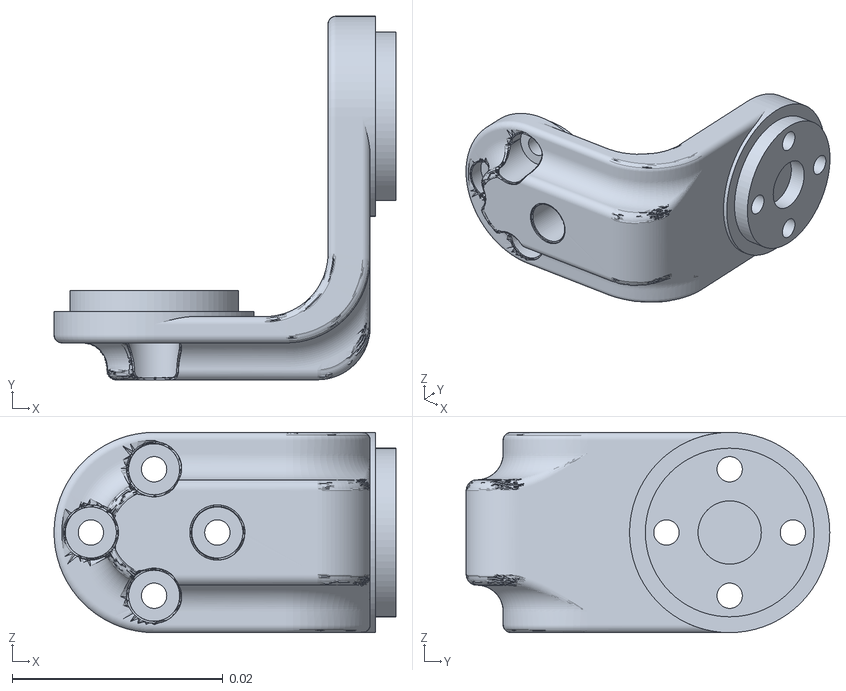
[picture p57: CAD file, 2026-11-01]
microduck_rl/src/mjlab_microduck/robot/microduck/assets/hip_l.stl
0.0325 x 0.0345 x 0.019
