mengwei666/microduck_scs225/microduck_rl/src/mjlab_microduck/robot/microduck/assets/speaker.stl

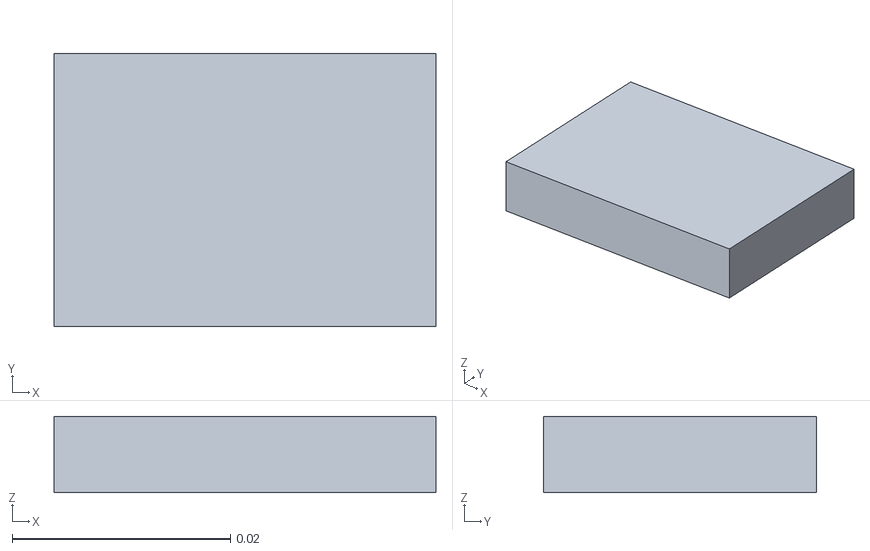
[picture p58: CAD file, 2026-11-01]
microduck_rl/src/mjlab_microduck/robot/microduck/assets/speaker.stl
0.035 x 0.025 x 0.007
