mengwei666/microduck_scs225/microduck_rl/src/mjlab_microduck/robot/microduck/assets/elec_rpi_robot_hat_pcb.stl

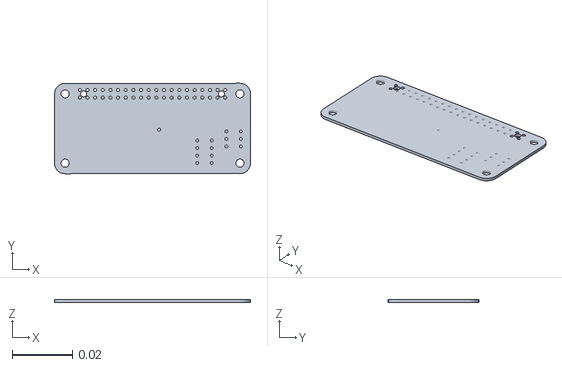
[picture p59: CAD file, 2026-11-01]
microduck_rl/src/mjlab_microduck/robot/microduck/assets/elec_rpi_robot_hat_pcb.stl
0.065 x 0.03 x 0.00084
