mengwei666/microduck_scs225/microduck_rl/src/mjlab_microduck/robot/microduck/assets/neck.stl

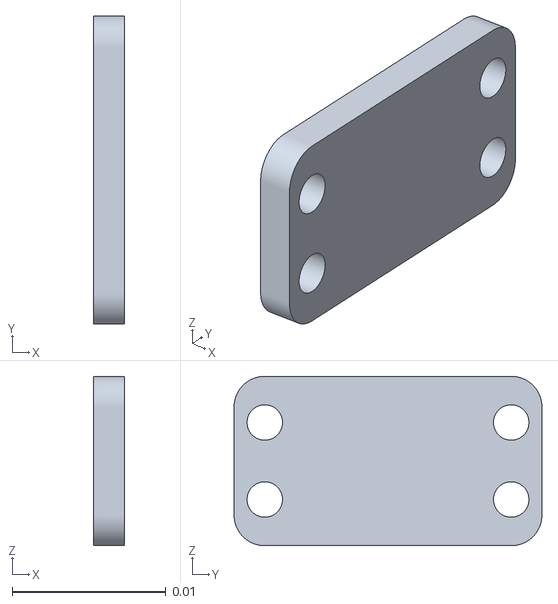
[picture p60: CAD file, 2026-11-01]
microduck_rl/src/mjlab_microduck/robot/microduck/assets/neck.stl
0.002 x 0.02 x 0.011
