mengwei666/microduck_scs225/(list of files, cad)

Other CAD files:
microduck_cad/05、microduck_v3/stl/右大腿上盖.3mf
microduck_cad/05、microduck_v3/07、左大腿下盖.SLDPRT
microduck_rl/src/mjlab_microduck/robot/microduck/assets/ankle_r_v1.stl
microduck_cad/04、microduck_v2/11、左脚踝.SLDPRT
microduck_cad/04、microduck_v2/07、左大腿下盖.SLDPRT
microduck_cad/05、microduck_v3/11、左脚踝.SLDPRT
microduck_rl/src/mjlab_microduck/robot/microduck/assets/foot_right.stl
microduck_rl/src/mjlab_microduck/robot/microduck/assets/upper_leg_left.stl
microduck_rl/src/mjlab_microduck/robot/microduck/assets/ankle_left.stl
microduck_rl/src/mjlab_microduck/robot/microduck/assets/xl330.stl
microduck_rl/src/mjlab_microduck/robot/microduck/assets/sole_right.stl
microduck_cad/04、microduck_v2/stl/01、主体结构.3mf
microduck_cad/04、microduck_v2/stl/01、主体结构.STL
microduck_cad/04、microduck_v2/stl/03、胯部X2.STL
microduck_cad/04、microduck_v2/stl/04、胯筋X2.STL
microduck_cad/04、microduck_v2/stl/05、大腿上盖X2.STL
microduck_cad/04、microduck_v2/stl/06、右大腿下盖.STL
microduck_cad/04、microduck_v2/stl/07、左大腿下盖.STL
microduck_cad/04、microduck_v2/stl/08、小腿X2.STL
microduck_cad/04、microduck_v2/stl/10、右脚踝.STL
microduck_cad/04、microduck_v2/stl/11、左脚踝.STL
microduck_cad/05、microduck_v3/stl/01、主体结构.3mf
microduck_cad/05、microduck_v3/stl/01、主体结构.STL
microduck_cad/05、microduck_v3/stl/03、胯部X2.STL
microduck_cad/05、microduck_v3/stl/04、胯筋X2.STL
microduck_cad/05、microduck_v3/stl/08、小腿X2.STL
microduck_cad/05、microduck_v3/stl/10、右脚踝.STL
microduck_cad/05、microduck_v3/stl/11、左脚踝.STL
microduck_cad/05、microduck_v3/stl/右大腿上盖.STL
