mengwei666/microduck_scs225/(commit log)

2026-11-01 ***20261101*** > 添加cda模型
2026-11-02 ***20261102*** > 整理文件
2026-11-04 ***20261104*** > 训练策略
